esden/glasgow/hardware/boards/glasgow-revB1/glasgow.kicad_pcb

## KiCad design hardware/boards/glasgow-revB1/glasgow.kicad_pcb (2018-11-22)

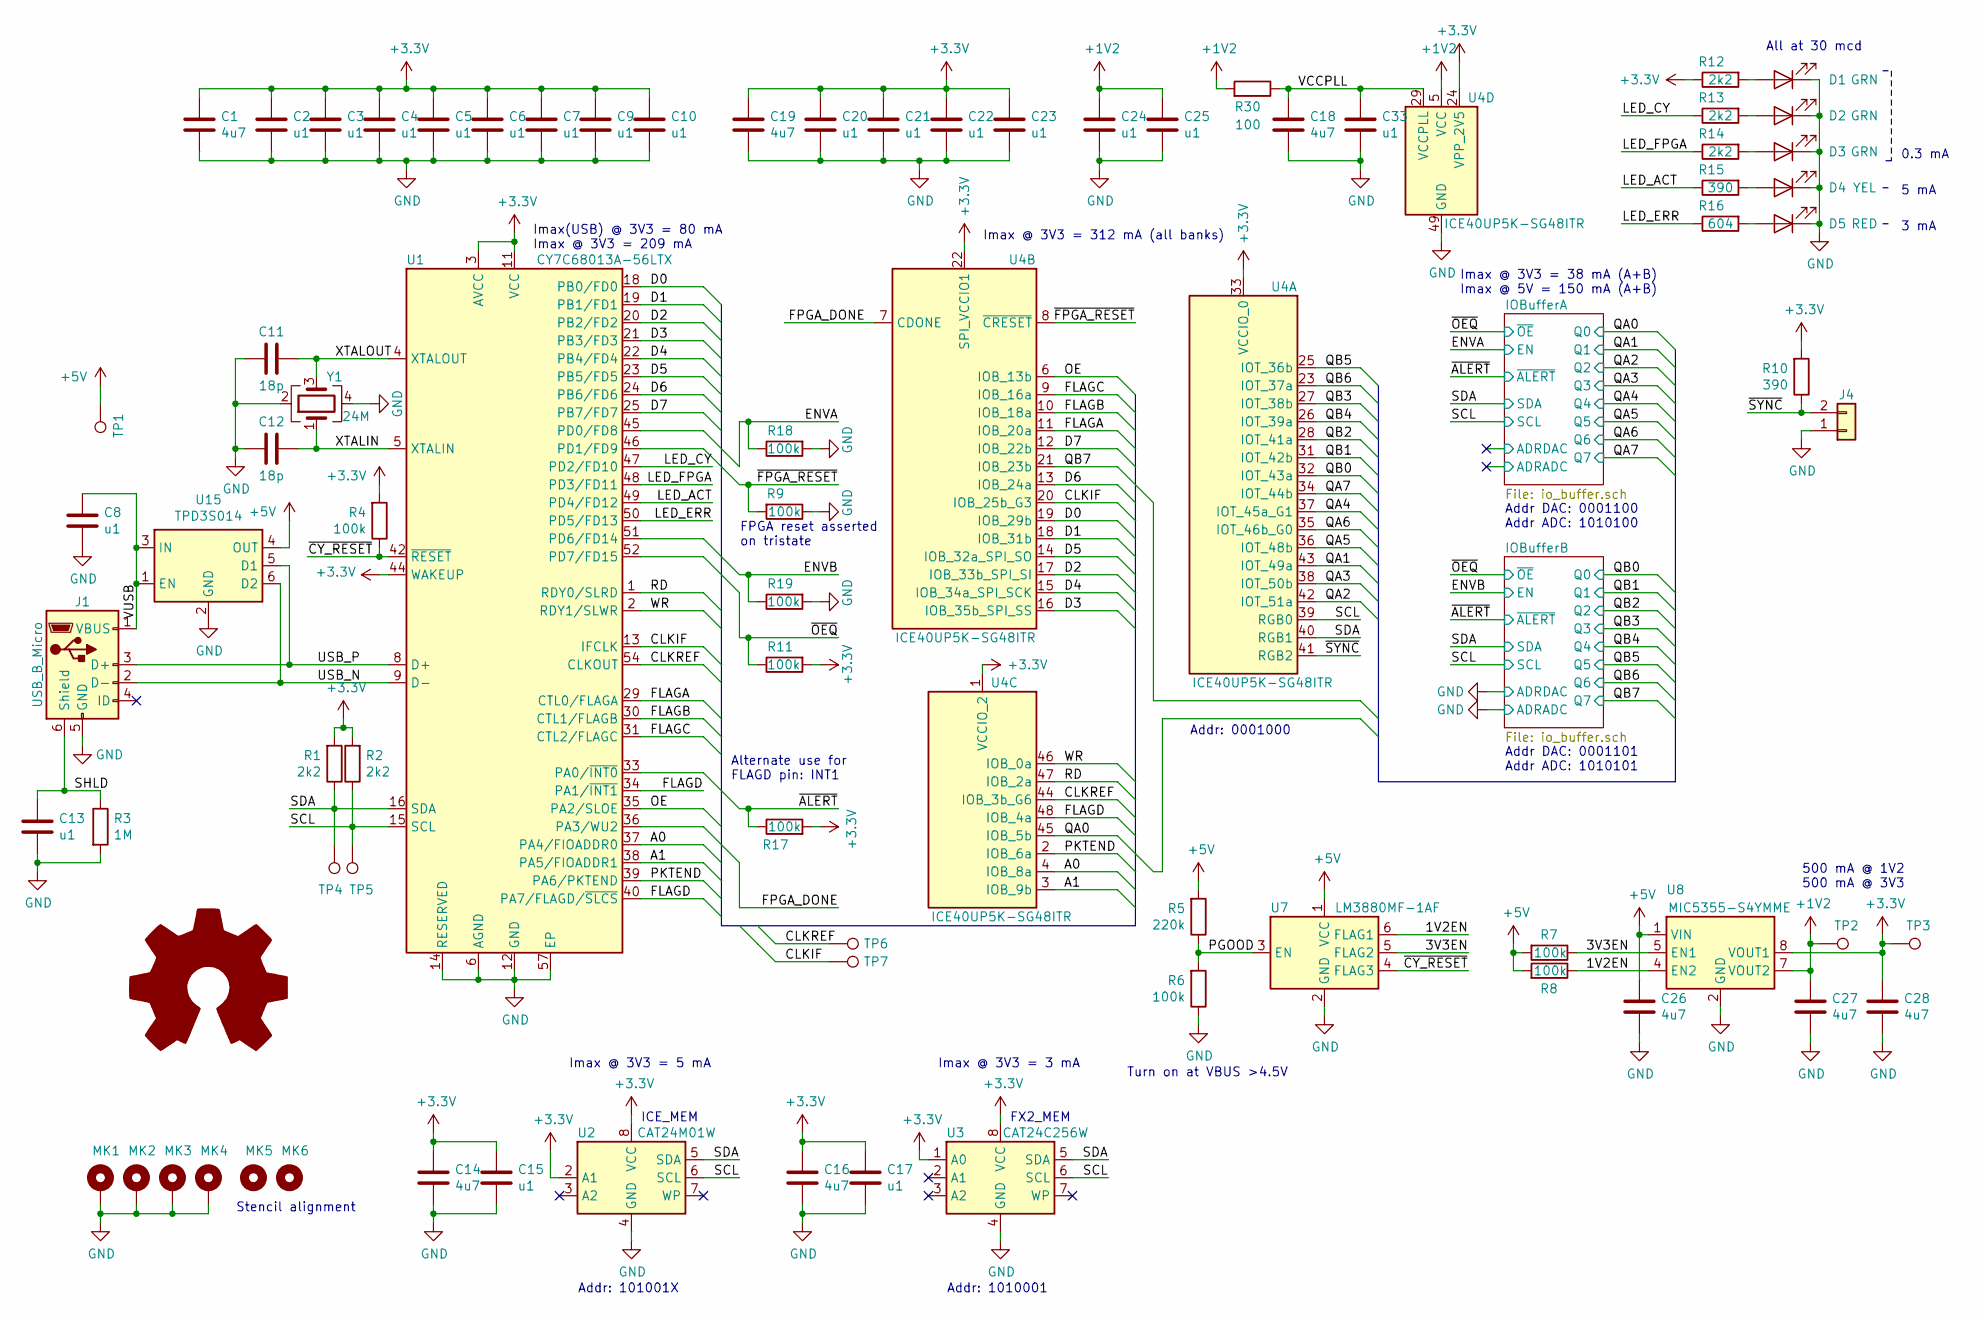
[picture p6: schematic glasgow.sch, Base Board]

Parts:
C1, C14, C16, C18, C19, C26, C27, C28: 4u7; C_0603_1608Metric_Pad0.99x1.00mm_HandSolder; MPN LMK107BJ475KAHT
C2, C3, C4, C5, C6, C7, C8, C9, C10, C13, C15, C17, C20, C21, C22, C23, C24, C25, C33: u1; C_0603_1608Metric_Pad0.99x1.00mm_HandSolder; MPN TMK107BJ154KA-T
C11, C12: 18p; C_0603_1608Metric_Pad0.99x1.00mm_HandSolder; MPN CC0603JRNPO8BN180
D1, D2, D3: GRN; LED_0603_1608Metric_Pad0.82x1.00mm_HandSolder; MPN 150060GS75000
D4: YEL; LED_0603_1608Metric_Pad0.82x1.00mm_HandSolder; MPN 150060YS75000
D5: RED; LED_0603_1608Metric_Pad0.82x1.00mm_HandSolder; MPN 150060RS75000
J1: USB_B_Micro; USB_Micro-B_Molex_47346-0001; MPN 47346-0001
J4: Conn_01x02; PinHeader_1x02_P2.54mm_Horizontal; MPN 22-05-3021
MK1, MK2, MK3, MK4: Mounting_Hole_PAD; MountingHole_3.2mm_M3_Pad
MK5, MK6: Mounting_Hole; MountingHole_2.5mm
R1, R2, R12, R13, R14: 2k2; R_0603_1608Metric_Pad0.99x1.00mm_HandSolder; MPN RC0603FR-132K2L
R3: 1M; R_0603_1608Metric_Pad0.99x1.00mm_HandSolder; MPN RC0603FR-131ML
R4, R6, R7, R8, R9, R11, R17, R18, R19: 100k; R_0603_1608Metric_Pad0.99x1.00mm_HandSolder; MPN RC0603FR-10100KL
R5: 220k; R_0603_1608Metric_Pad0.99x1.00mm_HandSolder; MPN RC0603FR-10220KL
R10, R15: 390; R_0603_1608Metric_Pad0.99x1.00mm_HandSolder; MPN RC0603FR-13390RL
R16: 604; R_0603_1608Metric_Pad0.99x1.00mm_HandSolder; MPN RC0603FR-07604RL
R30: 100; R_0603_1608Metric_Pad0.99x1.00mm_HandSolder; MPN RC0603FR-07100RL
TP1: 5V; TestPoint_Pad_D1.0mm
TP2: 1V2; TestPoint_Pad_D1.0mm
TP3, TP7: 3V3; TestPoint_Pad_D1.0mm
TP4: SDA; TestPoint_Pad_D1.0mm
TP5: SCL; TestPoint_Pad_D1.0mm
TP6: CLKREF; TestPoint_Pad_D1.0mm
U1: CY7C68013A-56LTX; Cypress_QFN-56-1EP_8x8mm_P0.5mm_EP6.22x6.22mm_ThermalVias; MPN CY7C68013A-56LTXC
U2: CAT24M01W; SOIC-8_3.9x4.9mm_P1.27mm; MPN CAT24M01WI-GT3
U3: CAT24C256W; SOIC-8_3.9x4.9mm_P1.27mm; MPN CAT24C256WI-GT3
U4: ICE40UP5K-SG48ITR; QFN-48-1EP_7x7mm_P0.5mm_EP5.15x5.15mm; MPN ICE40UP5K-SG48ITR50
U7: LM3880MF-1AF; SOT-23-6; MPN LM3880MFX-1AF/NOPB
U8: MIC5355-S4YMME; MSOP-8-1EP_3x3mm_P0.65mm_EP2.54x2.8mm_ThermalVias; MPN MIC5355-S4YMME
U15: TPD3S014; SOT-23-6; MPN TPD3S014DBVR
Y1: 24M; Crystal_SMD_3225-4pin_3.2x2.5mm; MPN LFXTAL058124REEL

Connections:
+1V2: C24.1, C25.1, C27.1, R30.2, TP2.1, U4.5 (VCC), U4.30 (VCC), U8.7 (VOUT2)
+3V3: C1.1, C2.1, C3.1, C4.1, C5.1, C6.1, C7.1, C9.1, C10.1, C14.1, C15.1, C16.1, C17.1, C19.1, C20.1, C21.1, C22.1, C23.1, C28.1, R1.2, R2.2, R4.2, R10.2, R11.2, R12.1, R17.2, TP3.1, U1.3 (AVCC), U1.7 (AVCC), U1.11 (VCC), U1.17 (VCC), U1.27 (VCC), U1.32 (VCC), U1.43 (VCC), U1.44 (WAKEUP), U1.55 (VCC), U2.2 (A1), U2.8 (VCC), U3.1 (A0), U3.8 (VCC), U4.1 (VCCIO_2), U4.22 (SPI_VCCIO1), U4.24 (VPP_2V5), U4.33 (VCCIO_0), U8.8 (VOUT1); also elsewhere on the board
+5V: C26.1, R5.2, R7.2, R8.2, TP1.1, U7.1 (VCC), U8.1 (VIN), U15.4 (OUT); also elsewhere on the board
/1V2EN: R8.1, U7.6 (FLAG1), U8.4 (EN2)
/3V3EN: R7.1, U7.5 (FLAG2), U8.5 (EN1)
/A0: U1.37 (PA4/FIOADDR0), U4.4 (IOB_8a)
/A1: U1.38 (PA5/FIOADDR1), U4.3 (IOB_9b)
/CLKIF: TP7.1, U1.13 (IFCLK), U4.20 (IOB_25b_G3)
/CLKREF: TP6.1, U1.54 (CLKOUT), U4.44 (IOB_3b_G6)
/D0: U1.18 (PB0/FD0), U4.19 (IOB_29b)
/D1: U1.19 (PB1/FD1), U4.18 (IOB_31b)
/D2: U1.20 (PB2/FD2), U4.17 (IOB_33b_SPI_SI)
/D3: U1.21 (PB3/FD3), U4.16 (IOB_35b_SPI_SS)
/D4: U1.22 (PB4/FD4), U4.15 (IOB_34a_SPI_SCK)
/D5: U1.23 (PB5/FD5), U4.14 (IOB_32a_SPI_SO)
/D6: U1.24 (PB6/FD6), U4.13 (IOB_24a)
/D7: U1.25 (PB7/FD7), U4.12 (IOB_22b)
/ENVA: R18.1, U1.45 (PD0/FD8); also elsewhere on the board
/ENVB: R19.1, U1.51 (PD6/FD14); also elsewhere on the board
/FLAGA: U1.29 (CTL0/FLAGA), U4.11 (IOB_20a)
/FLAGB: U1.30 (CTL1/FLAGB), U4.10 (IOB_18a)
/FLAGC: U1.31 (CTL2/FLAGC), U4.9 (IOB_16a)
/FLAGD: U1.34 (PA1/~INT1), U1.40 (PA7/FLAGD/~SLCS), U4.48 (IOB_4a)
/FPGA_DONE: U1.36 (PA3/WU2), U4.7 (CDONE)
/LED_ACT: R15.1, U1.49 (PD4/FD12)
/LED_CY: R13.1, U1.47 (PD2/FD10)
/LED_ERR: R16.1, U1.50 (PD5/FD13)
/LED_FPGA: R14.1, U1.48 (PD3/FD11)
/OE: U1.35 (PA2/SLOE), U4.6 (IOB_13b)
/PGOOD: R5.1, R6.2, U7.3 (EN)
/PKTEND: U1.39 (PA6/PKTEND), U4.2 (IOB_6a)
/QA0: U4.45 (IOB_5b); also elsewhere on the board
/QA1: U4.43 (IOT_49a); also elsewhere on the board
/QA2: U4.42 (IOT_51a); also elsewhere on the board
/QA3: U4.38 (IOT_50b); also elsewhere on the board
/QA4: U4.37 (IOT_45a_G1); also elsewhere on the board
/QA5: U4.36 (IOT_48b); also elsewhere on the board
/QA6: U4.35 (IOT_46b_G0); also elsewhere on the board
/QA7: U4.34 (IOT_44b); also elsewhere on the board
/QB0: U4.32 (IOT_43a); also elsewhere on the board
/QB1: U4.31 (IOT_42b); also elsewhere on the board
/QB2: U4.28 (IOT_41a); also elsewhere on the board
/QB3: U4.27 (IOT_38b); also elsewhere on the board
/QB4: U4.26 (IOT_39a); also elsewhere on the board
/QB5: U4.25 (IOT_36b); also elsewhere on the board
/QB6: U4.23 (IOT_37a); also elsewhere on the board
/QB7: U4.21 (IOB_23b); also elsewhere on the board
/RD: U1.1 (RDY0/SLRD), U4.47 (IOB_2a)
/SCL: R2.1, TP5.1, U1.15 (SCL), U2.6 (SCL), U3.6 (SCL), U4.39 (RGB0); also elsewhere on the board
/SDA: R1.1, TP4.1, U1.16 (SDA), U2.5 (SDA), U3.5 (SDA), U4.40 (RGB1); also elsewhere on the board
/SHLD: C13.1, J1.6 (Shield), R3.1
/USB_N: J1.2 (D-), U1.9 (D-), U15.6 (D2)
/USB_P: J1.3 (D+), U1.8 (D+), U15.5 (D1)
/VCCPLL: C18.1, C33.1, R30.1, U4.29 (VCCPLL)
/VUSB: C8.1, J1.1 (VBUS), U15.1 (EN), U15.3 (IN)
/WR: U1.2 (RDY1/SLWR), U4.46 (IOB_0a)
/XTALIN: C12.1, U1.5 (XTALIN), Y1.1
/XTALOUT: C11.1, U1.4 (XTALOUT), Y1.3
/~ALERT: R17.1, U1.33 (PA0/~INT0); also elsewhere on the board
/~CY_RESET: R4.1, U1.42 (~RESET), U7.4 (FLAG3)
/~FPGA_RESET: R9.2, U1.46 (PD1/FD9), U4.8 (~CRESET)
/~OEQ: R11.1, U1.52 (PD7/FD15); also elsewhere on the board
/~SYNC: J4.2, R10.1, U4.41 (RGB2)
GND: C1.2, C2.2, C3.2, C4.2, C5.2, C6.2, C7.2, C8.2, C9.2, C10.2, C11.2, C12.2, C13.2, C14.2, C15.2, C16.2, C17.2, C18.2, C19.2, C20.2, C21.2, C22.2, C23.2, C24.2, C25.2, C26.2, C27.2, C28.2, C33.2, D1.1 (K), D2.1 (K), D3.1 (K), D4.1 (K), D5.1 (K), J1.5 (GND), J4.1, MK1.1, MK2.1, MK3.1, MK4.1, R3.2, R6.1, R9.1, R18.2, R19.2, U1.6 (AGND), U1.10 (AGND), U1.12 (GND), U1.14 (RESERVED), U1.26 (GND), U1.28 (GND), U1.41 (GND), U1.53 (GND), U1.56 (GND), U1.57 (EP), U2.4 (GND), U3.4 (GND), U4.49 (GND), U7.2 (GND), U8.2 (GND), U8.9 (GND), U15.2 (GND), Y1.2, Y1.4; also elsewhere on the board
unnamed: D1.2 (A), R12.2
unnamed: D2.2 (A), R13.2
unnamed: D3.2 (A), R14.2
unnamed: D4.2 (A), R15.2
unnamed: D5.2 (A), R16.2

Notes on the sheet:
All at 30 mcd
0.3 mA
5 mA
3 mA
Stencil alignment
Alternate use for FLAGD pin: INT1
Turn on at VBUS >4.5V
Addr: 101001X
Addr: 1010001
500 mA @ 1V2 500 mA @ 3V3
Addr DAC: 0001100 Addr ADC: 1010100
Addr DAC: 0001101 Addr ADC: 1010101
FPGA reset asserted on tristate
Imax @ 3V3 = 312 mA (all banks)
Imax @ 3V3 = 5 mA
Imax @ 3V3 = 3 mA
Imax(USB) @ 3V3 = 80 mA Imax @ 3V3 = 209 mA
Imax @ 3V3 = 38 mA (A+B) Imax @ 5V = 150 mA (A+B)
Addr: 0001000
FX2_MEM
ICE_MEM
