esden/glasgow/hardware/boards/glasgow-revB1/glasgow.kicad_pcb

## KiCad design hardware/boards/glasgow-revB1/glasgow.kicad_pcb (continued)

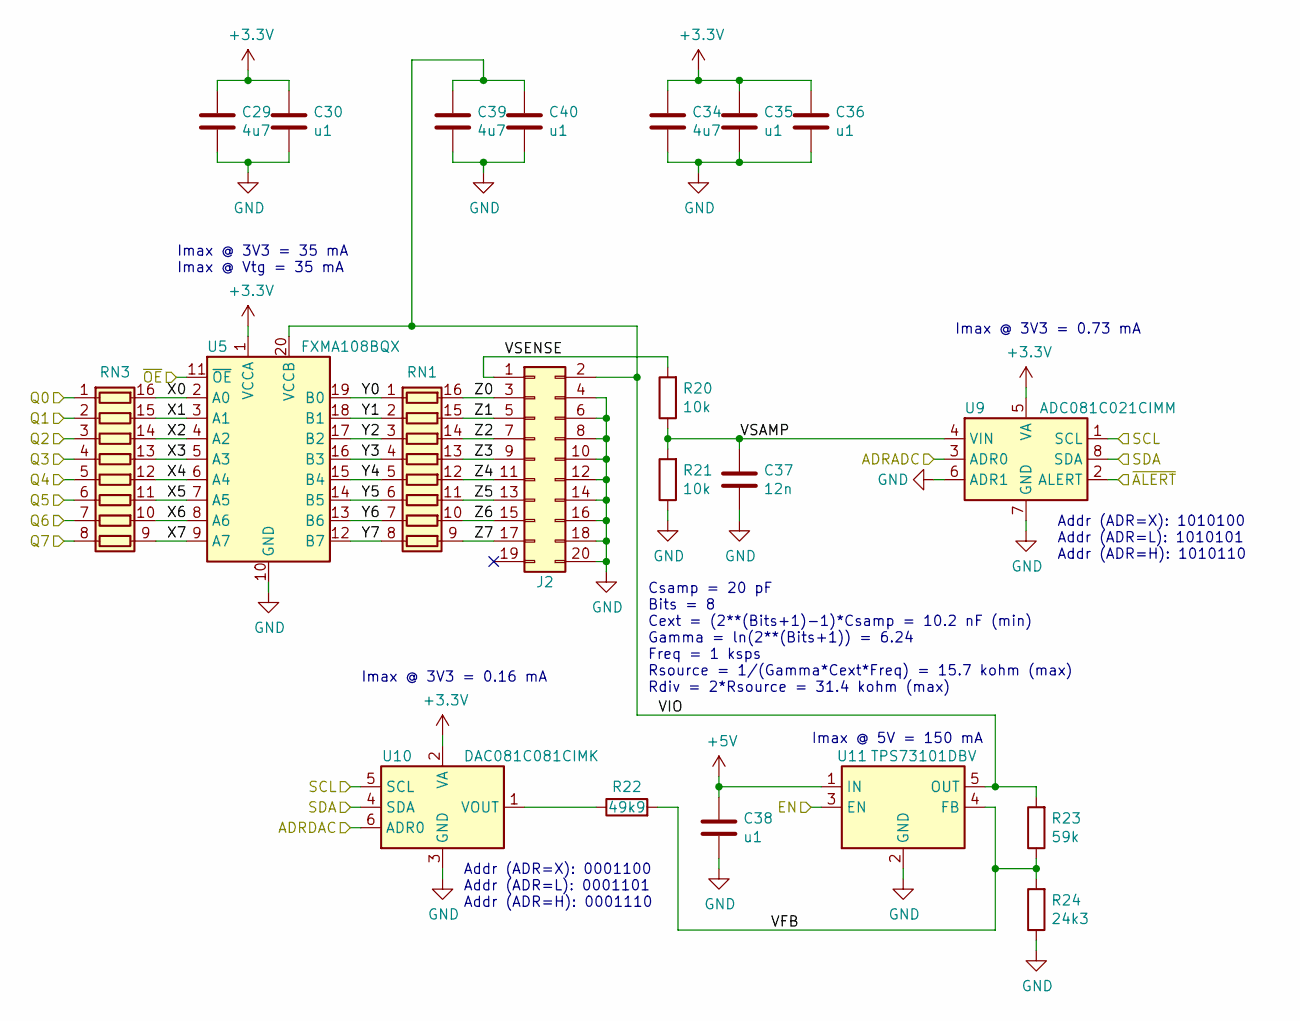
[picture p7: schematic io_buffer.sch, I/O Buffer]

Parts:
C29, C34, C39: 4u7; C_0603_1608Metric_Pad0.99x1.00mm_HandSolder; MPN LMK107BJ475KAHT
C30, C35, C36, C38, C40: u1; C_0603_1608Metric_Pad0.99x1.00mm_HandSolder; MPN TMK107BJ154KA-T
C37: 12n; C_0603_1608Metric_Pad0.99x1.00mm_HandSolder; MPN CC0603KRX7R8BB123
J2: Conn_02x10_Odd_Even; PinHeader_2x10_P2.54mm_Vertical; MPN 87834-2019
R20, R21: 10k; R_0603_1608Metric_Pad0.99x1.00mm_HandSolder; MPN RC0603FR-1010KL
R22: 49k9; R_0603_1608Metric_Pad0.99x1.00mm_HandSolder; MPN RC0603FR-0749K9L
R23: 59k; R_0603_1608Metric_Pad0.99x1.00mm_HandSolder; MPN RC0603FR-0759KL
R24: 24k3; R_0603_1608Metric_Pad0.99x1.00mm_HandSolder; MPN AC0603FR-0724K3L
RN1, RN3: R_Pack08; R_Array_Convex_8x0602; MPN TBD
U5: FXMA108BQX; WQFN-20-1EP_2.5x4.5mm_P0.5mm_EP1x2.9mm; MPN FXMA108BQX
U9: ADC081C021CIMM; MSOP-8_3x3mm_P0.65mm; MPN ADC081C021CIMM/NOPB
U10: DAC081C081CIMK; SOT-23-6; MPN DAC081C081CIMK/NOPB
U11: TPS73101DBV; SOT-23-5; MPN TPS73101DBVR

Connections:
+3V3: C29.1, C30.1, C34.1, C35.1, C36.1, U5.1 (VCCA), U9.5 (VA), U10.2 (VA); also elsewhere on the board
+5V: C38.1, U11.1 (IN); also elsewhere on the board
/ENVA: U11.3 (EN); also elsewhere on the board
/IOBufferA/ADRADC: U9.3 (ADR0)
/IOBufferA/ADRDAC: U10.6 (ADR0)
/IOBufferA/VFB: R22.2, R23.1, R24.2, U11.4 (FB)
/IOBufferA/VIO: C39.1, C40.1, J2.2, R23.2, U5.20 (VCCB), U11.5 (OUT)
/IOBufferA/VSAMP: C37.1, R20.1, R21.2, U9.4 (VIN)
/IOBufferA/VSENSE: J2.1, R20.2
/IOBufferA/X0: RN3.16 (R1.2), U5.2 (A0)
/IOBufferA/X1: RN3.15 (R2.2), U5.3 (A1)
/IOBufferA/X2: RN3.14 (R3.2), U5.4 (A2)
/IOBufferA/X3: RN3.13 (R4.2), U5.5 (A3)
/IOBufferA/X4: RN3.12 (R5.2), U5.6 (A4)
/IOBufferA/X5: RN3.11 (R6.2), U5.7 (A5)
/IOBufferA/X6: RN3.10 (R7.2), U5.8 (A6)
/IOBufferA/X7: RN3.9 (R8.2), U5.9 (A7)
/IOBufferA/Y0: RN1.1 (R1.1), U5.19 (B0)
/IOBufferA/Y1: RN1.2 (R2.1), U5.18 (B1)
/IOBufferA/Y2: RN1.3 (R3.1), U5.17 (B2)
/IOBufferA/Y3: RN1.4 (R4.1), U5.16 (B3)
/IOBufferA/Y4: RN1.5 (R5.1), U5.15 (B4)
/IOBufferA/Y5: RN1.6 (R6.1), U5.14 (B5)
/IOBufferA/Y6: RN1.7 (R7.1), U5.13 (B6)
/IOBufferA/Y7: RN1.8 (R8.1), U5.12 (B7)
/IOBufferA/Z0: J2.3, RN1.16 (R1.2)
/IOBufferA/Z1: J2.5, RN1.15 (R2.2)
/IOBufferA/Z2: J2.7, RN1.14 (R3.2)
/IOBufferA/Z3: J2.9, RN1.13 (R4.2)
/IOBufferA/Z4: J2.11, RN1.12 (R5.2)
/IOBufferA/Z5: J2.13, RN1.11 (R6.2)
/IOBufferA/Z6: J2.15, RN1.10 (R7.2)
/IOBufferA/Z7: J2.17, RN1.9 (R8.2)
/QA0: RN3.1 (R1.1); also elsewhere on the board
/QA1: RN3.2 (R2.1); also elsewhere on the board
/QA2: RN3.3 (R3.1); also elsewhere on the board
/QA3: RN3.4 (R4.1); also elsewhere on the board
/QA4: RN3.5 (R5.1); also elsewhere on the board
/QA5: RN3.6 (R6.1); also elsewhere on the board
/QA6: RN3.7 (R7.1); also elsewhere on the board
/QA7: RN3.8 (R8.1); also elsewhere on the board
/SCL: U9.1 (SCL), U10.5 (SCL); also elsewhere on the board
/SDA: U9.8 (SDA), U10.4 (SDA); also elsewhere on the board
/~ALERT: U9.2 (ALERT); also elsewhere on the board
/~OEQ: U5.11 (~OE); also elsewhere on the board
GND: C29.2, C30.2, C34.2, C35.2, C36.2, C37.2, C38.2, C39.2, C40.2, J2.4, J2.6, J2.8, J2.10, J2.12, J2.14, J2.16, J2.18, J2.20, R21.1, R24.1, U5.10 (GND), U9.6 (ADR1), U9.7 (GND), U10.3 (GND), U11.2 (GND); also elsewhere on the board
unnamed: R22.1, U10.1 (VOUT)

Parts of its further copies:
C31, C41, C46: 4u7; C_0603_1608Metric_Pad0.99x1.00mm_HandSolder; MPN LMK107BJ475KAHT
C32, C42, C43, C45, C47: u1; C_0603_1608Metric_Pad0.99x1.00mm_HandSolder; MPN TMK107BJ154KA-T
C44: 12n; C_0603_1608Metric_Pad0.99x1.00mm_HandSolder; MPN CC0603KRX7R8BB123
J3: Conn_02x10_Odd_Even; PinHeader_2x10_P2.54mm_Vertical; MPN 87834-2019
R25, R26: 10k; R_0603_1608Metric_Pad0.99x1.00mm_HandSolder; MPN RC0603FR-1010KL
R27: 49k9; R_0603_1608Metric_Pad0.99x1.00mm_HandSolder; MPN RC0603FR-0749K9L
R28: 59k; R_0603_1608Metric_Pad0.99x1.00mm_HandSolder; MPN RC0603FR-0759KL
R29: 24k3; R_0603_1608Metric_Pad0.99x1.00mm_HandSolder; MPN AC0603FR-0724K3L
RN2, RN4: R_Pack08; R_Array_Convex_8x0602; MPN TBD
U6: FXMA108BQX; WQFN-20-1EP_2.5x4.5mm_P0.5mm_EP1x2.9mm; MPN FXMA108BQX
U12: ADC081C021CIMM; MSOP-8_3x3mm_P0.65mm; MPN ADC081C021CIMM/NOPB
U13: DAC081C081CIMK; SOT-23-6; MPN DAC081C081CIMK/NOPB
U14: TPS73101DBV; SOT-23-5; MPN TPS73101DBVR

Connections of its further copies:
+3V3: C31.1, C32.1, C41.1, C42.1, C43.1, U6.1 (VCCA), U12.5 (VA), U13.2 (VA); also elsewhere on the board
+5V: C45.1, U14.1 (IN); also elsewhere on the board
/ENVB: U14.3 (EN); also elsewhere on the board
/IOBufferB/VFB: R27.2, R28.1, R29.2, U14.4 (FB)
/IOBufferB/VIO: C46.1, C47.1, J3.2, R28.2, U6.20 (VCCB), U14.5 (OUT)
/IOBufferB/VSAMP: C44.1, R25.1, R26.2, U12.4 (VIN)
/IOBufferB/VSENSE: J3.1, R25.2
/IOBufferB/X0: RN4.16 (R1.2), U6.2 (A0)
/IOBufferB/X1: RN4.15 (R2.2), U6.3 (A1)
/IOBufferB/X2: RN4.14 (R3.2), U6.4 (A2)
/IOBufferB/X3: RN4.13 (R4.2), U6.5 (A3)
/IOBufferB/X4: RN4.12 (R5.2), U6.6 (A4)
/IOBufferB/X5: RN4.11 (R6.2), U6.7 (A5)
/IOBufferB/X6: RN4.10 (R7.2), U6.8 (A6)
/IOBufferB/X7: RN4.9 (R8.2), U6.9 (A7)
/IOBufferB/Y0: RN2.1 (R1.1), U6.19 (B0)
/IOBufferB/Y1: RN2.2 (R2.1), U6.18 (B1)
/IOBufferB/Y2: RN2.3 (R3.1), U6.17 (B2)
/IOBufferB/Y3: RN2.4 (R4.1), U6.16 (B3)
/IOBufferB/Y4: RN2.5 (R5.1), U6.15 (B4)
/IOBufferB/Y5: RN2.6 (R6.1), U6.14 (B5)
/IOBufferB/Y6: RN2.7 (R7.1), U6.13 (B6)
/IOBufferB/Y7: RN2.8 (R8.1), U6.12 (B7)
/IOBufferB/Z0: J3.3, RN2.16 (R1.2)
/IOBufferB/Z1: J3.5, RN2.15 (R2.2)
/IOBufferB/Z2: J3.7, RN2.14 (R3.2)
/IOBufferB/Z3: J3.9, RN2.13 (R4.2)
/IOBufferB/Z4: J3.11, RN2.12 (R5.2)
/IOBufferB/Z5: J3.13, RN2.11 (R6.2)
/IOBufferB/Z6: J3.15, RN2.10 (R7.2)
/IOBufferB/Z7: J3.17, RN2.9 (R8.2)
/QB0: RN4.1 (R1.1); also elsewhere on the board
/QB1: RN4.2 (R2.1); also elsewhere on the board
/QB2: RN4.3 (R3.1); also elsewhere on the board
/QB3: RN4.4 (R4.1); also elsewhere on the board
/QB4: RN4.5 (R5.1); also elsewhere on the board
/QB5: RN4.6 (R6.1); also elsewhere on the board
/QB6: RN4.7 (R7.1); also elsewhere on the board
/QB7: RN4.8 (R8.1); also elsewhere on the board
/SCL: U12.1 (SCL), U13.5 (SCL); also elsewhere on the board
/SDA: U12.8 (SDA), U13.4 (SDA); also elsewhere on the board
/~ALERT: U12.2 (ALERT); also elsewhere on the board
/~OEQ: U6.11 (~OE); also elsewhere on the board
GND: C31.2, C32.2, C41.2, C42.2, C43.2, C44.2, C45.2, C46.2, C47.2, J3.4, J3.6, J3.8, J3.10, J3.12, J3.14, J3.16, J3.18, J3.20, R26.1, R29.1, U6.10 (GND), U12.3 (ADR0), U12.6 (ADR1), U12.7 (GND), U13.3 (GND), U13.6 (ADR0), U14.2 (GND); also elsewhere on the board
unnamed: R27.1, U13.1 (VOUT)

Notes on the sheet:
Addr (ADR=X): 0001100 Addr (ADR=L): 0001101 Addr (ADR=H): 0001110
Addr (ADR=X): 1010100 Addr (ADR=L): 1010101 Addr (ADR=H): 1010110
Csamp = 20 pF Bits = 8 Cext = (2**(Bits+1)-1)*Csamp = 10.2 nF (min) Gamma = ln(2**(Bits+1)) = 6.24 Freq = 1 ksps Rsource = 1/(Gamma*Cext*Freq) = 15.7 kohm (max) Rdiv = 2*Rsource = 31.4 kohm (max)
Imax @ 3V3 = 0.16 mA
Imax @ 3V3 = 0.73 mA
Imax @ 5V = 150 mA
Imax @ 3V3 = 35 mA Imax @ Vtg = 35 mA

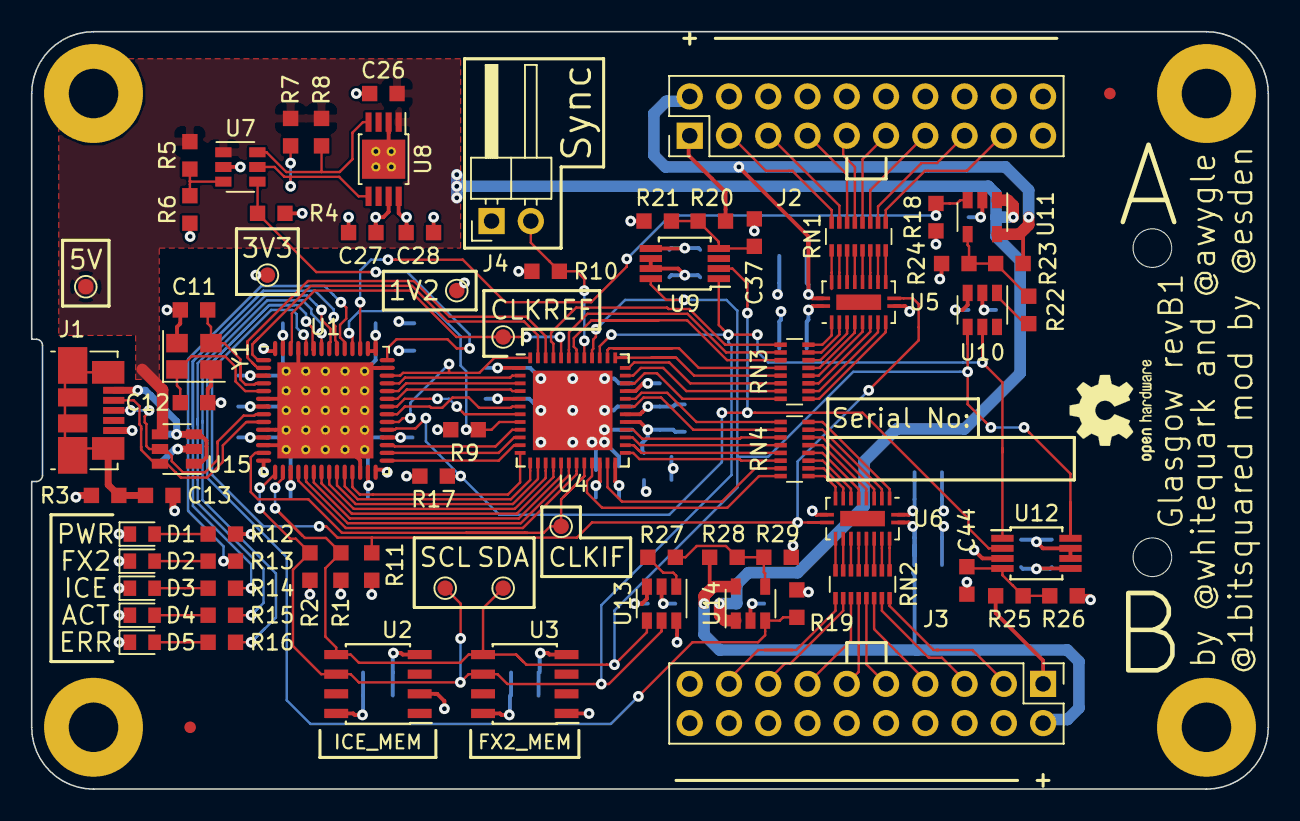
[picture p8: board hardware/boards/glasgow-revB1/glasgow.kicad_pcb from above]

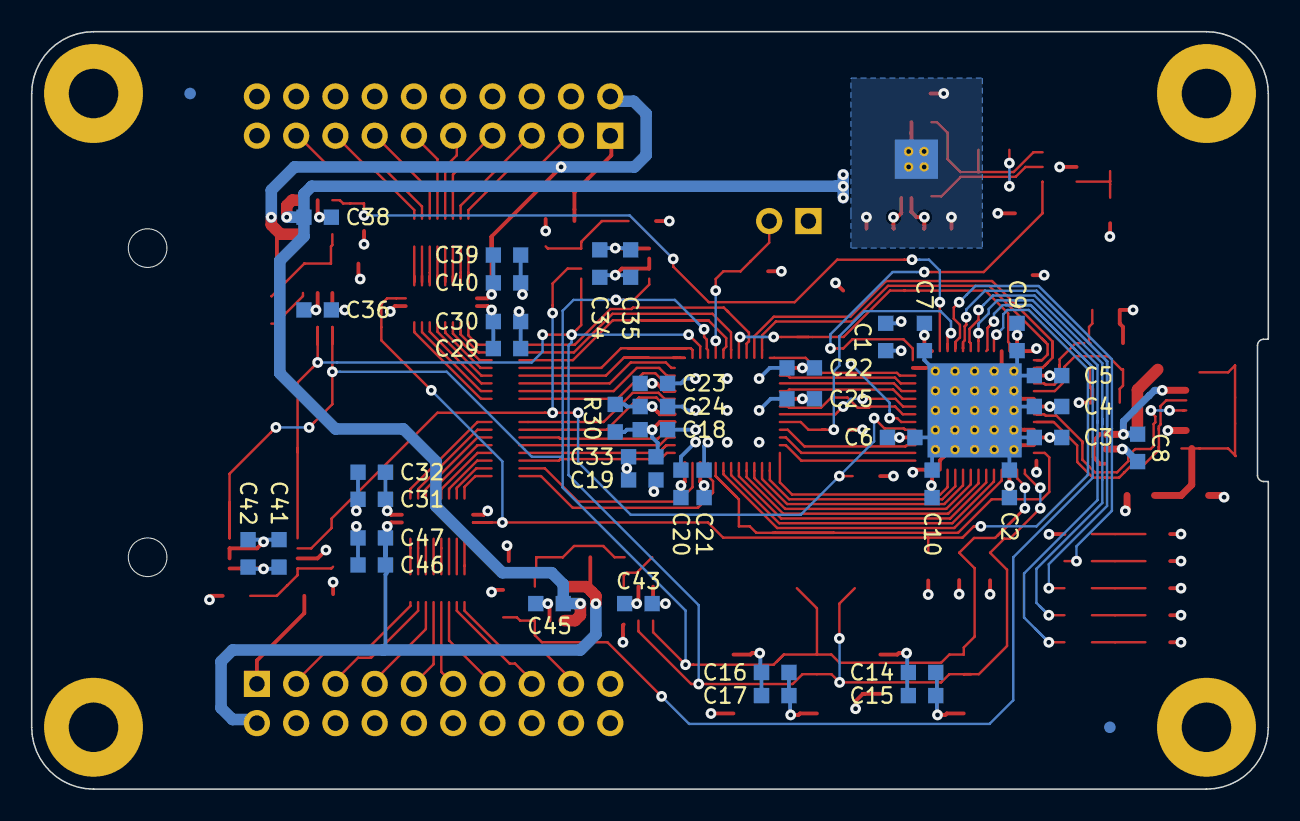
[picture p9: board hardware/boards/glasgow-revB1/glasgow.kicad_pcb from below]

Board: 4 copper layers, 80.0 x 49.0 mm, 123 parts (42 on the bottom side), 127 nets.

Other parts of the board:
FID1, FID1#2, FID2, FID4: Fiducial_0.75mm_Dia_1.5mm_Outer
